madderscientist/NUEDC_2023_D/练习题/AM解调/README.md

# AM解调
难点在输出的自动增益控制。<br>
ADF4350是f103zet6控制AD9954提供本振。<br>
c8t6文件夹是两级程控放大，原理是先控制精度高的为某一个放大等级不变，改另一个低精度的，再改精度高的。每级调整当距离设定点最近时停止，而不是设定范围，这样能保证精度和避免死循环。<br>
国赛也有一个增益调节，不过要求宽很多，大于1Vpp即可。用了一级调节，但思路类似。我们AGC还是做得很好的。
