madderscientist/NUEDC_2023_D/练习题/无线FM扩音系统/README.md

# 无线FM扩音
主要是读数据手册。TEA5767模块效果不行，噪音很大。RDA5820是非常优秀的FM调制模块！<br>
pdf是数据手册，代码相当于模块驱动。
