madderscientist/NUEDC_2023_D/练习题/无线FM扩音系统/RDA5820_发送端_final_c8t6/HARDWARE/KEY/key.c

#include "stm32f10x.h"                  // Device header
#include "key.h"
void Key_Init(void){    // B12:-1;B13:+1;B14:Auto;B15:分辨率
	RCC_APB2PeriphClockCmd(RCC_APB2Periph_GPIOB, ENABLE);

	GPIO_InitTypeDef GPIO_InitStructure;
	GPIO_InitStructure.GPIO_Mode = GPIO_Mode_IPU;	//上拉输入
	GPIO_InitStructure.GPIO_Pin = GPIO_Pin_12 | GPIO_Pin_13 | GPIO_Pin_14 | GPIO_Pin_15;
	GPIO_InitStructure.GPIO_Speed = GPIO_Speed_2MHz;
	GPIO_Init(GPIOB, &GPIO_InitStructure);
}
