madderscientist/NUEDC_2023_D/练习题/无线FM扩音系统/RDA5820_发送端_final_c8t6/HARDWARE/KEY/key.h

#ifndef __KEY_H
#define __KEY_H

#define KEY_SUB  GPIO_ReadInputDataBit(GPIOB,GPIO_Pin_12)
#define KEY_ADD  GPIO_ReadInputDataBit(GPIOB,GPIO_Pin_13)
#define KEY_AUTO   GPIO_ReadInputDataBit(GPIOB,GPIO_Pin_14)
#define KEY_ACC   GPIO_ReadInputDataBit(GPIOB,GPIO_Pin_15)


void Key_Init(void);
#endif
