madderscientist/NUEDC_2023_D/调制识别_F103ZET6/HARDWARE/ADC/adc.c

#include "adc.h"
#include "math.h"
#include "delay.h"

//初始化ADC
void  Adc_Init(uint32_t speed){
	RCC_APB2PeriphClockCmd(RCC_APB2Periph_GPIOA | RCC_APB2Periph_ADC1, ENABLE );	  //使能ADC1通道时钟
	RCC_ADCCLKConfig(RCC_PCLK2_Div6);   //设置ADC分频因子6 72M/6=12,ADC最大时间不能超过14M

    GPIO_InitTypeDef GPIO_InitStructure;
	GPIO_InitStructure.GPIO_Pin = GPIO_Pin_2;
	GPIO_InitStructure.GPIO_Mode = GPIO_Mode_AIN;		//模拟输入引脚
	GPIO_Init(GPIOA, &GPIO_InitStructure);

    ADC_InitTypeDef ADC_InitStructure;
    ADC_DeInit(ADC1);
	ADC_InitStructure.ADC_Mode = ADC_Mode_Independent;              //ADC工作模式:ADC1和ADC2工作在独立模式
	ADC_InitStructure.ADC_ScanConvMode = DISABLE;                   //模数转换工作 方式
	ADC_InitStructure.ADC_ContinuousConvMode = DISABLE;             //模数转换工作在单词转换
	ADC_InitStructure.ADC_ExternalTrigConv = ADC_ExternalTrigConv_T2_CC2;	//转换由外部定时器2的通道2输出的PWM波来实现adc的触发
	ADC_InitStructure.ADC_DataAlign = ADC_DataAlign_Right;	//ADC数据右对齐
	ADC_InitStructure.ADC_NbrOfChannel = 1;                 //顺序进行规则转换的ADC通道的数目
	ADC_Init(ADC1, &ADC_InitStructure);			            //根据ADC_InitStruct中指定的参数初始化外设ADCx的寄存器   

	ADC_Cmd(ADC1, ENABLE);	//使能指定的ADC1

    // 校准
	ADC_ResetCalibration(ADC1);
	while(ADC_GetResetCalibrationStatus(ADC1));
	ADC_StartCalibration(ADC1);
	while(ADC_GetCalibrationStatus(ADC1));

	ADC_RegularChannelConfig(ADC1, ADC_Channel_2, 1, speed);	//ADC1,ADC通道,采样时间为239.5周期	
	ADC_ExternalTrigConvCmd(ADC1, ENABLE);          //使能外部触发中断转换
	ADC_DMACmd(ADC1, ENABLE);                       //开启ADC1的DMA传输
}


void RMS_AD_Init(void){
	RCC_APB2PeriphClockCmd(RCC_APB2Periph_ADC2 | RCC_APB2Periph_GPIOA, ENABLE);
	RCC_ADCCLKConfig(RCC_PCLK2_Div6);
	
	GPIO_InitTypeDef GPIO_InitStructure;
	GPIO_InitStructure.GPIO_Mode = GPIO_Mode_AIN;
	GPIO_InitStructure.GPIO_Pin = GPIO_Pin_3;
	GPIO_InitStructure.GPIO_Speed = GPIO_Speed_50MHz;
	GPIO_Init(GPIOA, &GPIO_InitStructure);
	
	ADC_RegularChannelConfig(ADC2, ADC_Channel_3, 1, ADC_SampleTime_239Cycles5);
	
	ADC_InitTypeDef ADC_InitStructure;
	ADC_InitStructure.ADC_Mode = ADC_Mode_Independent;
	ADC_InitStructure.ADC_DataAlign = ADC_DataAlign_Right;
	ADC_InitStructure.ADC_ExternalTrigConv = ADC_ExternalTrigConv_None;
	ADC_InitStructure.ADC_ContinuousConvMode = DISABLE;
	ADC_InitStructure.ADC_ScanConvMode = DISABLE;
	ADC_InitStructure.ADC_NbrOfChannel = 1;
	ADC_Init(ADC2, &ADC_InitStructure);
	
	ADC_Cmd(ADC2, ENABLE);
	
	ADC_ResetCalibration(ADC2);
	while (ADC_GetResetCalibrationStatus(ADC2) == SET);
	ADC_StartCalibration(ADC2);
	while (ADC_GetCalibrationStatus(ADC2) == SET);
}

uint16_t RMS_AD_GetValue(void){
	ADC_SoftwareStartConvCmd(ADC2, ENABLE);
	while (ADC_GetFlagStatus(ADC2, ADC_FLAG_EOC) == RESET);
	return ADC_GetConversionValue(ADC2);
}

float RMS(void){    // 其实求了平均 返回毫伏
	double sum = 0;
	for(uint16_t i = 0; i<100; i++){
		// 3.3应该是实际3.3引脚的输出电压
		sum += 3.3 * RMS_AD_GetValue() / 4.095;
		delay_us(2);
	}
	return sum/100;
}
