madderscientist/NUEDC_2023_D/(notices)

Notices in the files:
练习题/单工无线通信/发射端ASK/HARDWARE/W25QXX/w25qxx.h:
Copyright(C) ¹ãÖÝÊÐÐÇÒíµç×Ó¿Æ¼¼ÓÐÏÞ¹«Ë¾ 2009-2019
All rights reserved
练习题/单工无线通信/发射端ASK/HARDWARE/TOUCH/gt9147.c:
Copyright(C) ¹ãÖÝÊÐÐÇÒíµç×Ó¿Æ¼¼ÓÐÏÞ¹«Ë¾ 2014-2024
